Acedio/flash_programmer/schematic.png

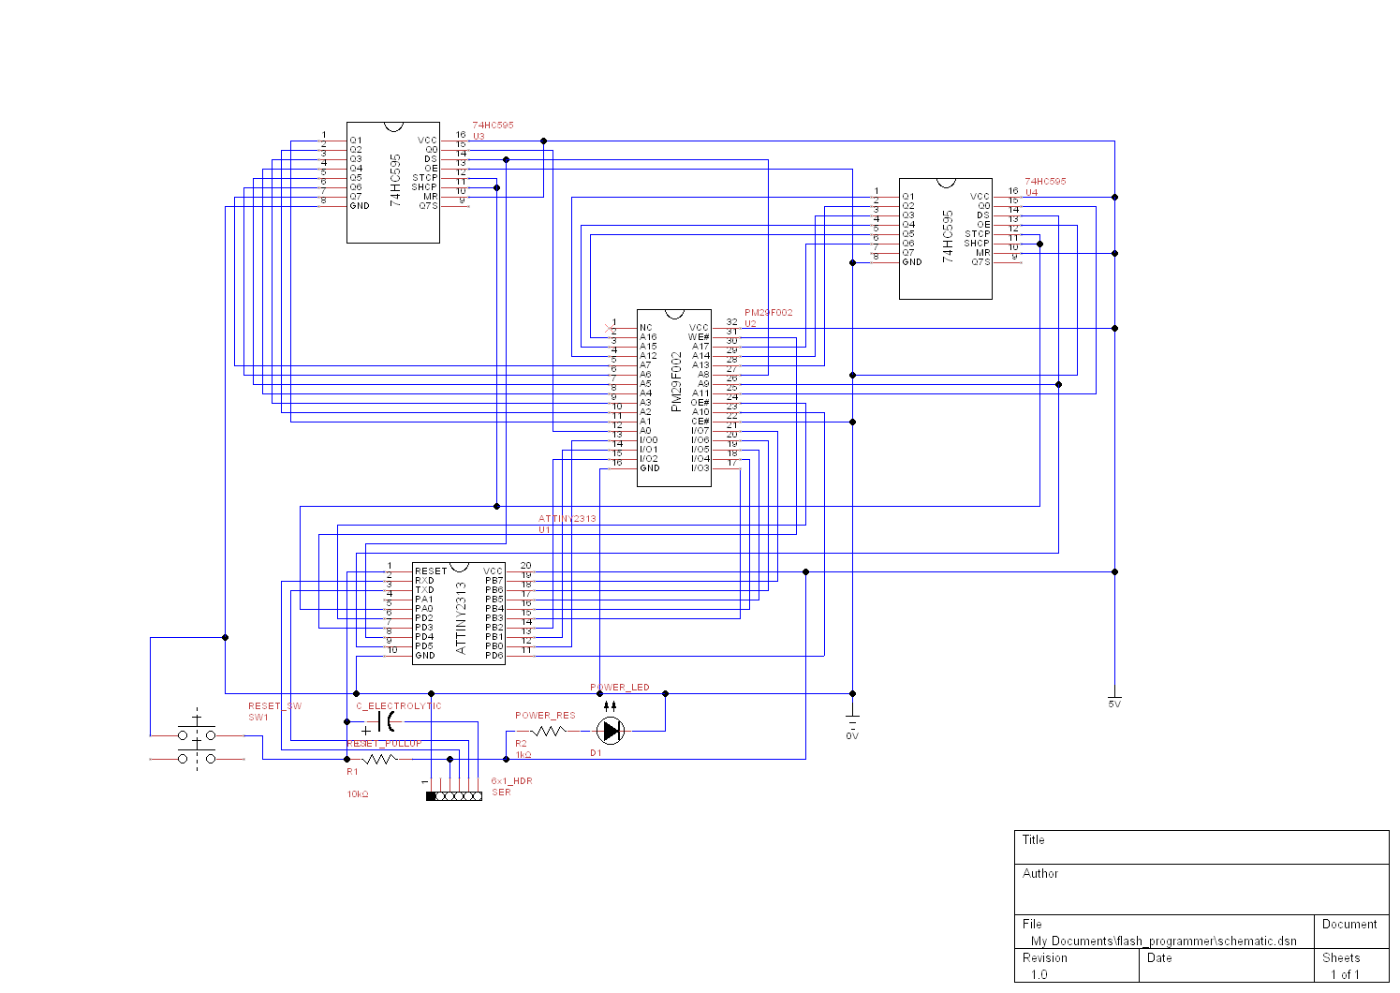
schematic.png
