Acedio/flash_programmer/stripboard.png

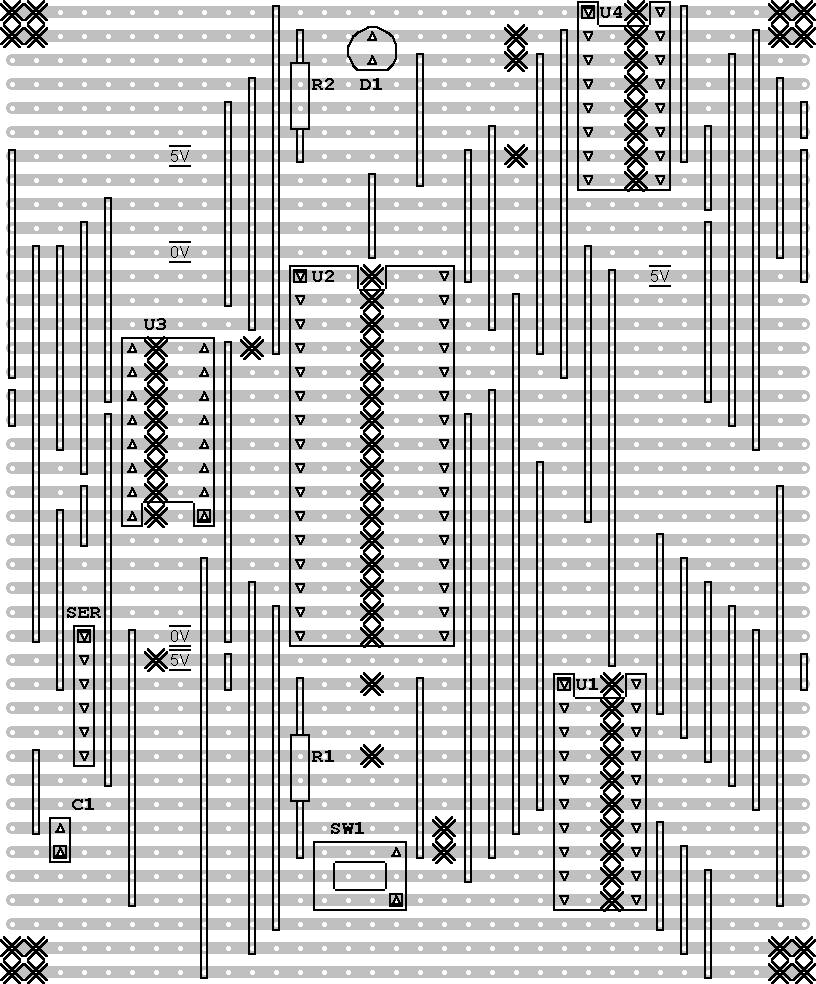
stripboard.png
