Acedio/flash_programmer/(list of files, drawings)

Other design files:
schematic.dsn
