Acedio/flash_programmer/(commit log)

2016-02-28 Working on the schematic.
    [schematic.dsn]
2016-02-28 Schematic draft 1.
    [schematic.dsn]
2016-02-29 Stripboard V2 with reset added.
    [schematic.dsn]
2016-03-02 Adding schematic image.
2016-03-19 For some reason, the default LED outline in VeeCAD has the wrong orientation. Fixing.
2016-03-20 Dumping is working. Fixed a bug where I was shifting high byte >> 8 rather than the necessary 11
    [program.c]
2016-03-21 Making address progress print a bit nicer in eep.py.
